NelsonBittencourt/PicArd/schematics/readme.md

# PicArd - Ultra-Low Cost PIC Programmer

## PicArd - Schematics

|  File | Description  |
| :--- | :---|
|*PicArd_Programmer_Hardware_Rev_3.pdf*| Current Hardware Programmer. Use this for new projects|
|*PicArd_Programmer_Hardware_Rev_2.pdf*| <b>For PICs with a 5V operating voltage</b>: use this revision as is (you can remove R12, R13, Q6, and Q7).<br><br><b>For PICs with an operating voltage below 5V</b>: adapt revision 2 with a level-shifter or use revision 3. |
|*PicArd_Programmer_Hardware_Rev_1_DEPRECATED.pdf* | Old Hardware Programmer. Not recommended for new projects |
