NelsonBittencourt/PicArd/Uno_Shield/readme.md

# PicArd - Ultra-Low Cost PIC Programmer

## PicArd - Arduino Uno Shield - Gerber Files

|  File | Description  |
| :--- | :---|
|*PicArd_Uno_Shield_Revision_3.zip*| Comming soon.|
|*PicArd_Uno_Shield_Revision_2.zip*| <b>For PICs with a 5V operating voltage</b>: use this revision as is (you can remove R12, R13, Q6, and Q7).<br><br><b>For PICs with an operating voltage below 5V</b>: adapt revision 2 with a level-shifter or use revision 3. |
|*PicArd_Uno_Shield_Revision_1_DEPRECATED.zip* | Old Hardware Programmer. Not recommended for new projects |
