NelsonBittencourt/PicArd/images/Picard_Hardware_041_Connection_Example_1.png

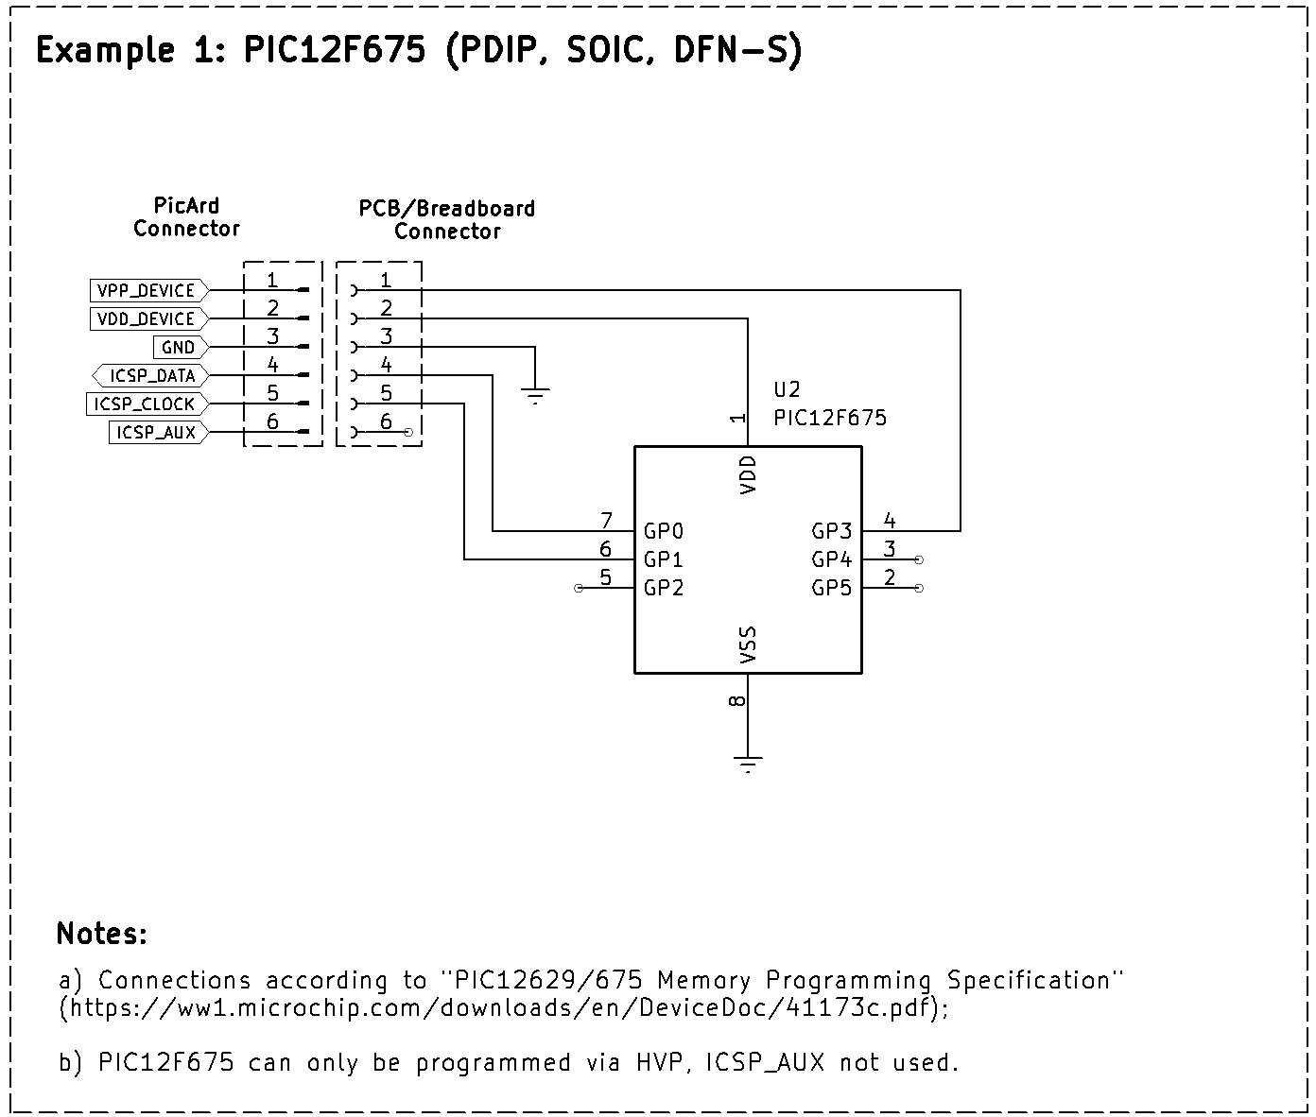
images/Picard_Hardware_041_Connection_Example_1.png
