NelsonBittencourt/PicArd/images/Picard_Hardware_041_Connection_Example_2.png

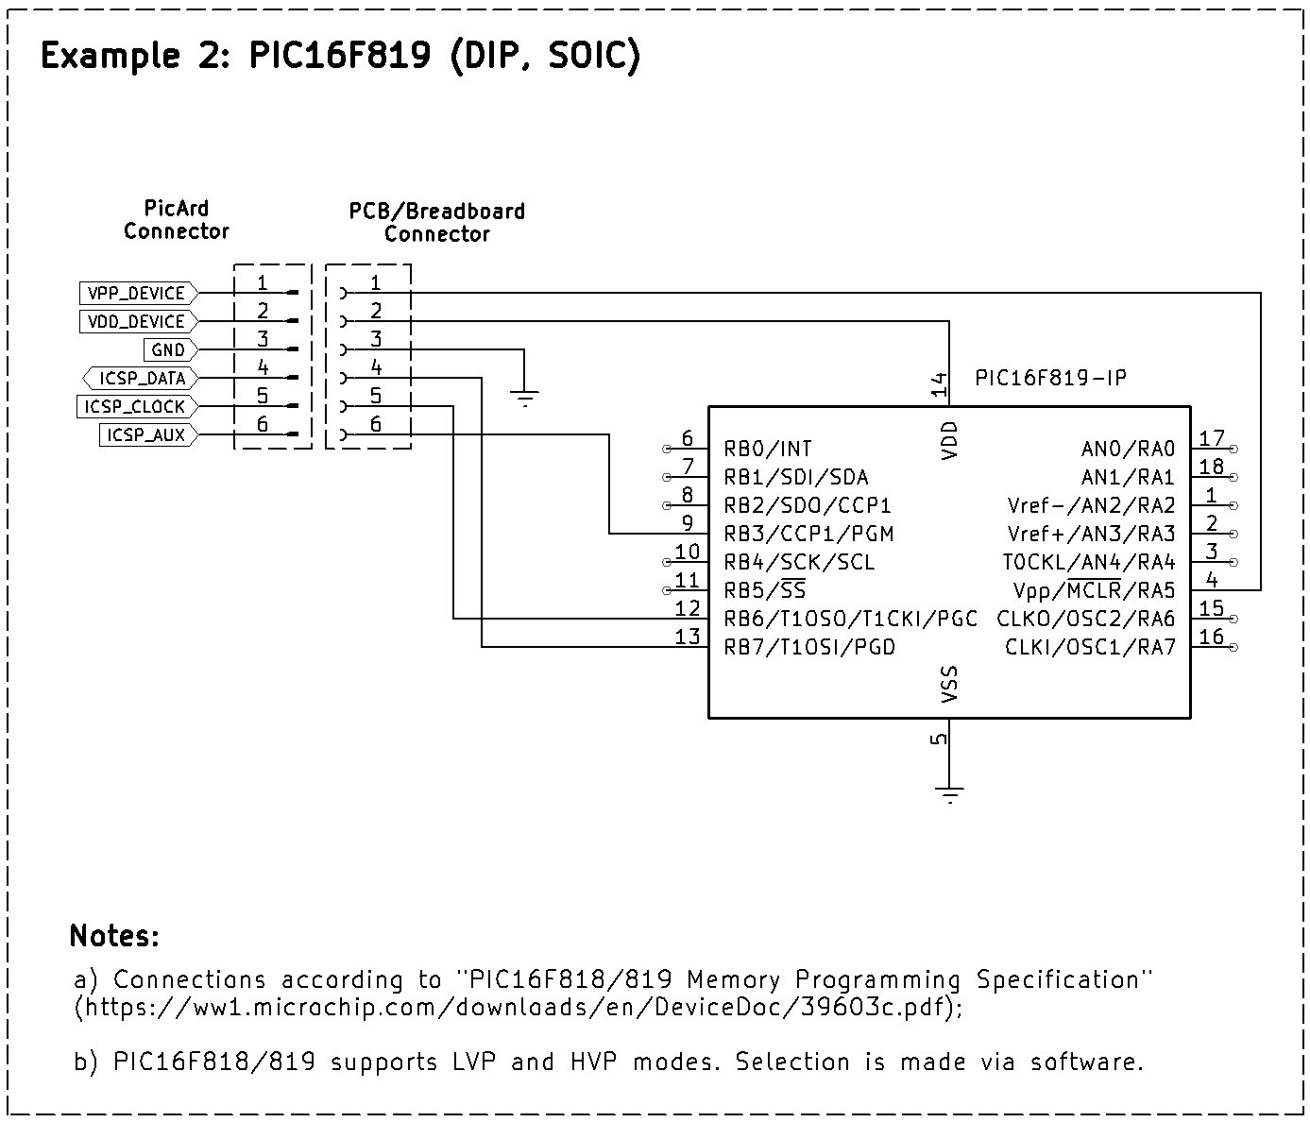
images/Picard_Hardware_041_Connection_Example_2.png
