NelsonBittencourt/PicArd/images/Picard_Hardware_041_VDD_Selection.png

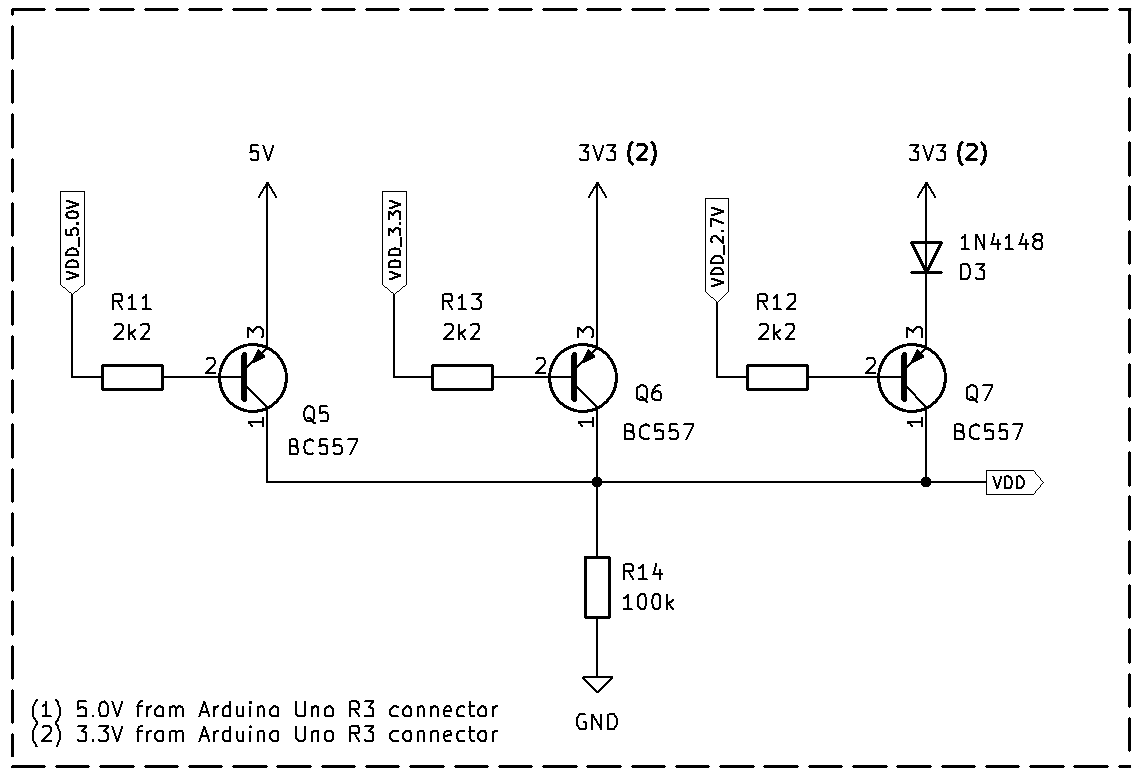
images/Picard_Hardware_041_VDD_Selection.png
