NelsonBittencourt/PicArd/images/Picard_Hardware_041_Voltages_Control.png

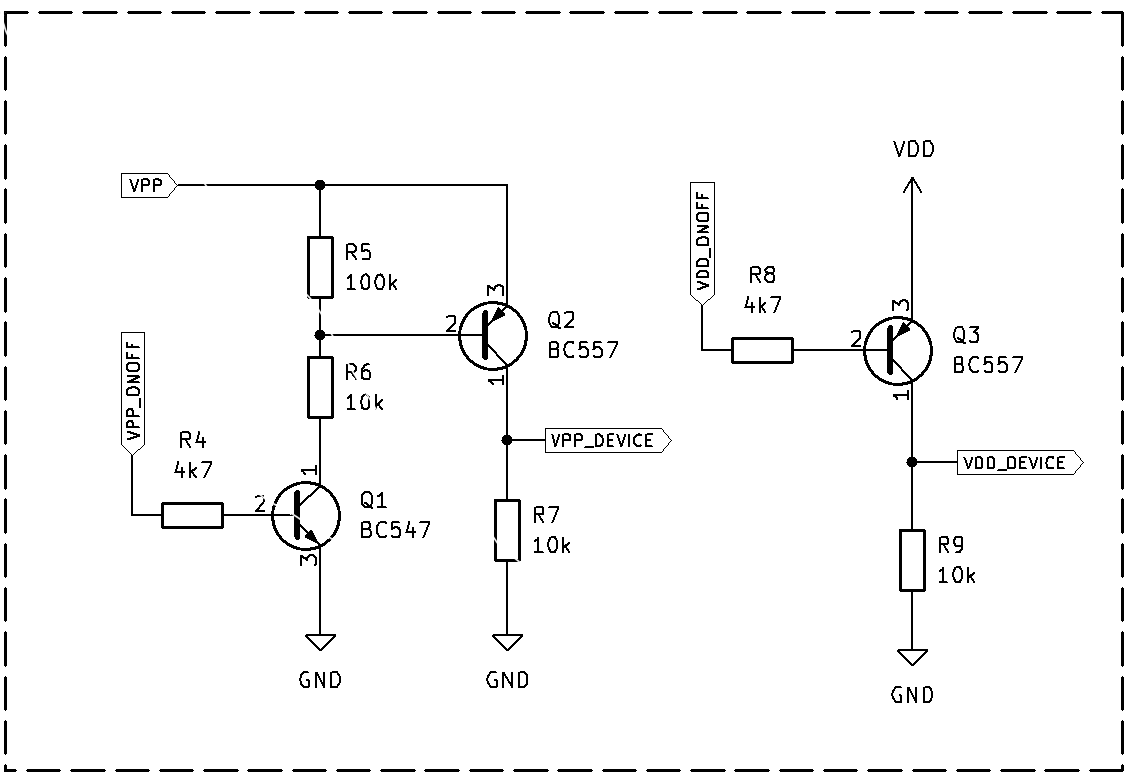
images/Picard_Hardware_041_Voltages_Control.png
