NelsonBittencourt/PicArd/images/Picard_Hardware_042_DC_DC_booster.png

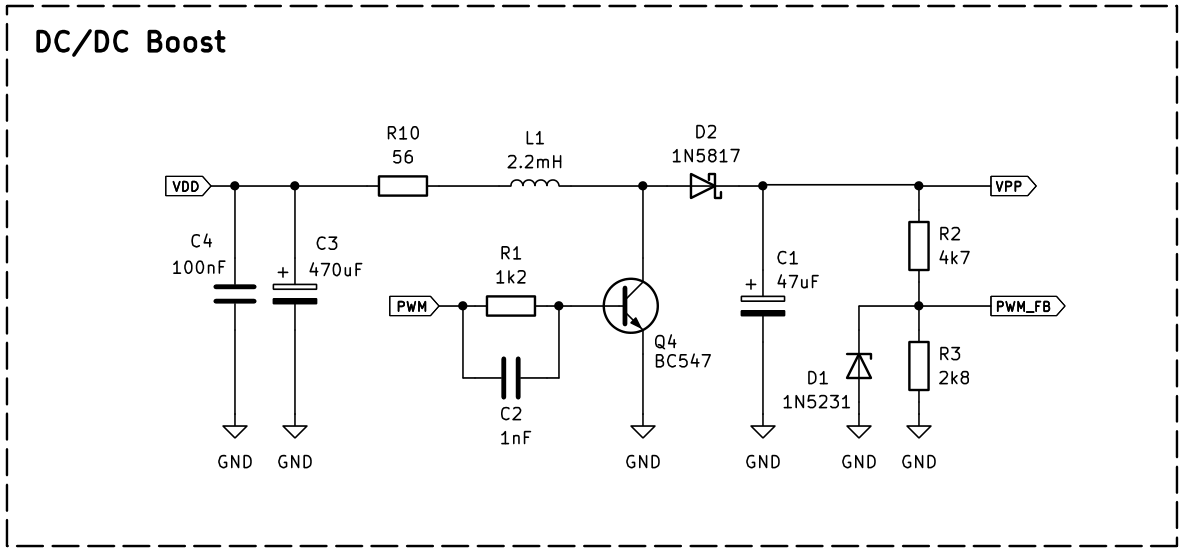
images/Picard_Hardware_042_DC_DC_booster.png
