NelsonBittencourt/PicArd/images/PicArd_Hardware_Uno_Shield_Rev_2_Ray.png

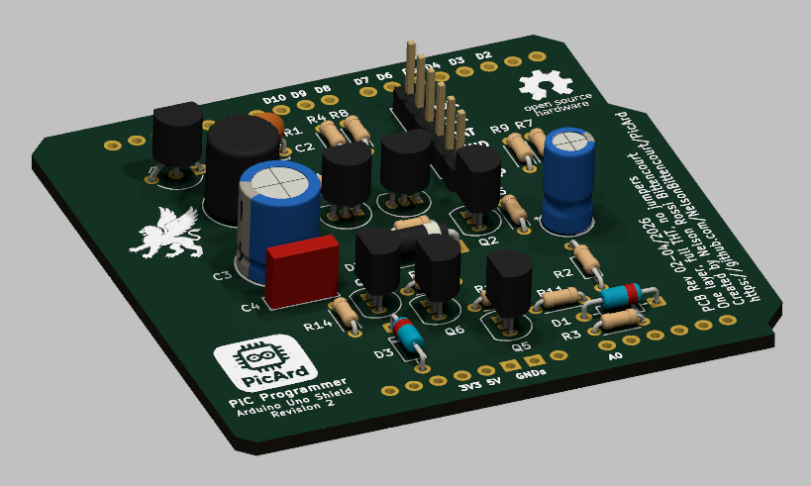
images/PicArd_Hardware_Uno_Shield_Rev_2_Ray.png
