NelsonBittencourt/PicArd/schematics/PicArd_Programmer_Hardware_Rev_3.pdf

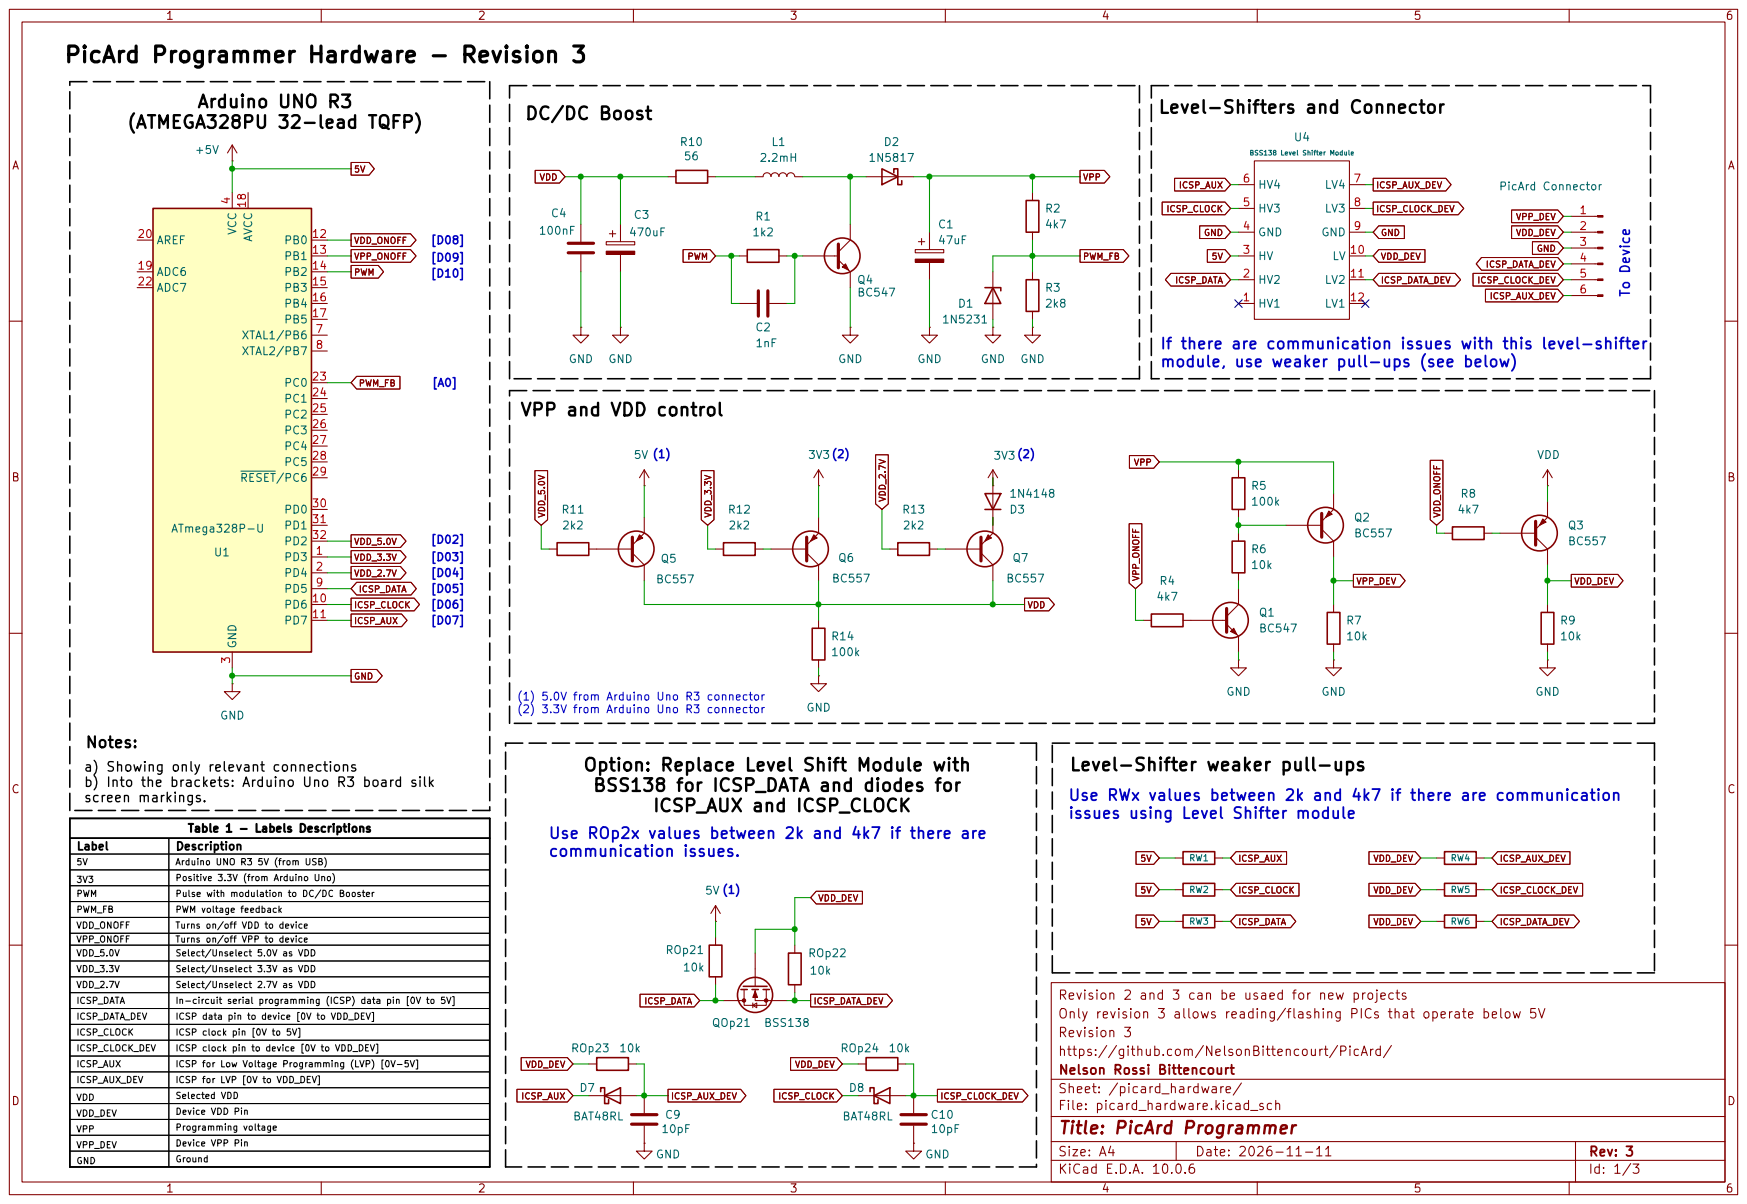
[picture p16: page 1]

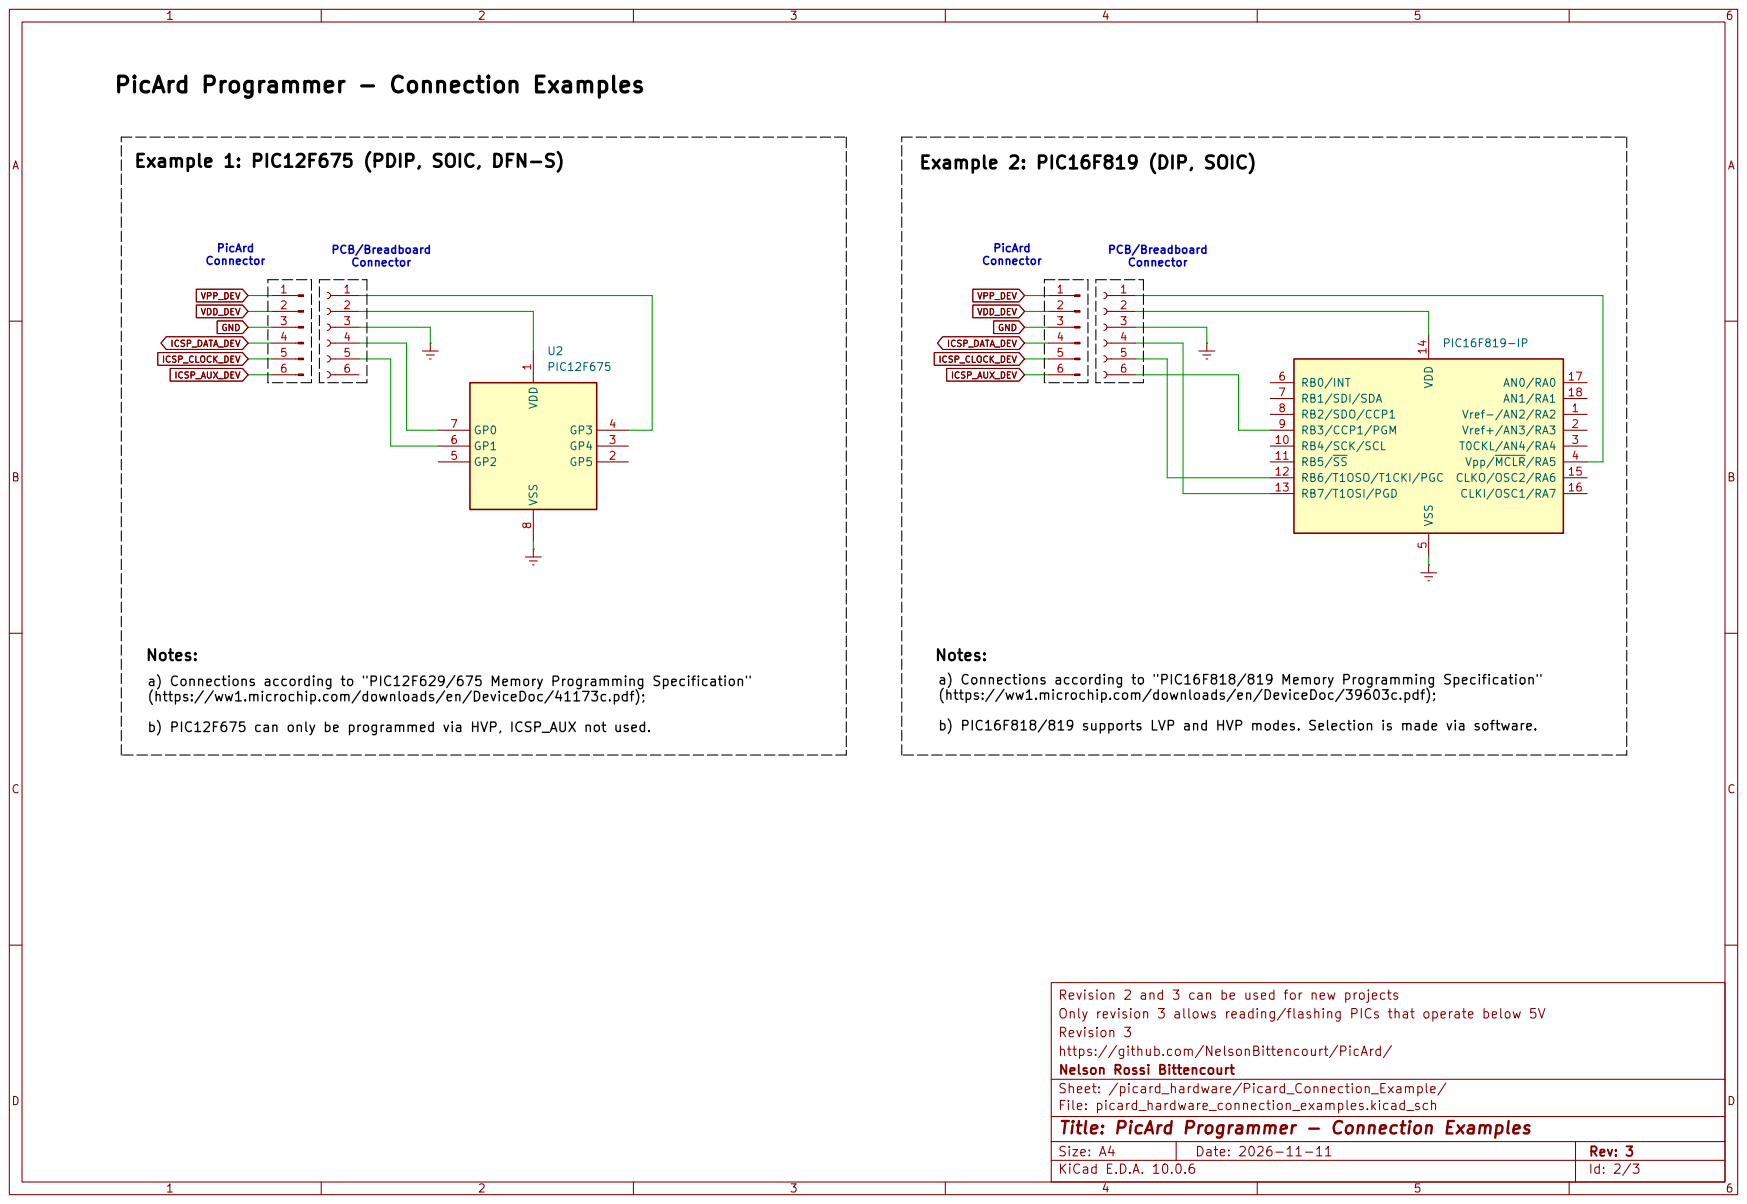
[picture p17: page 2]

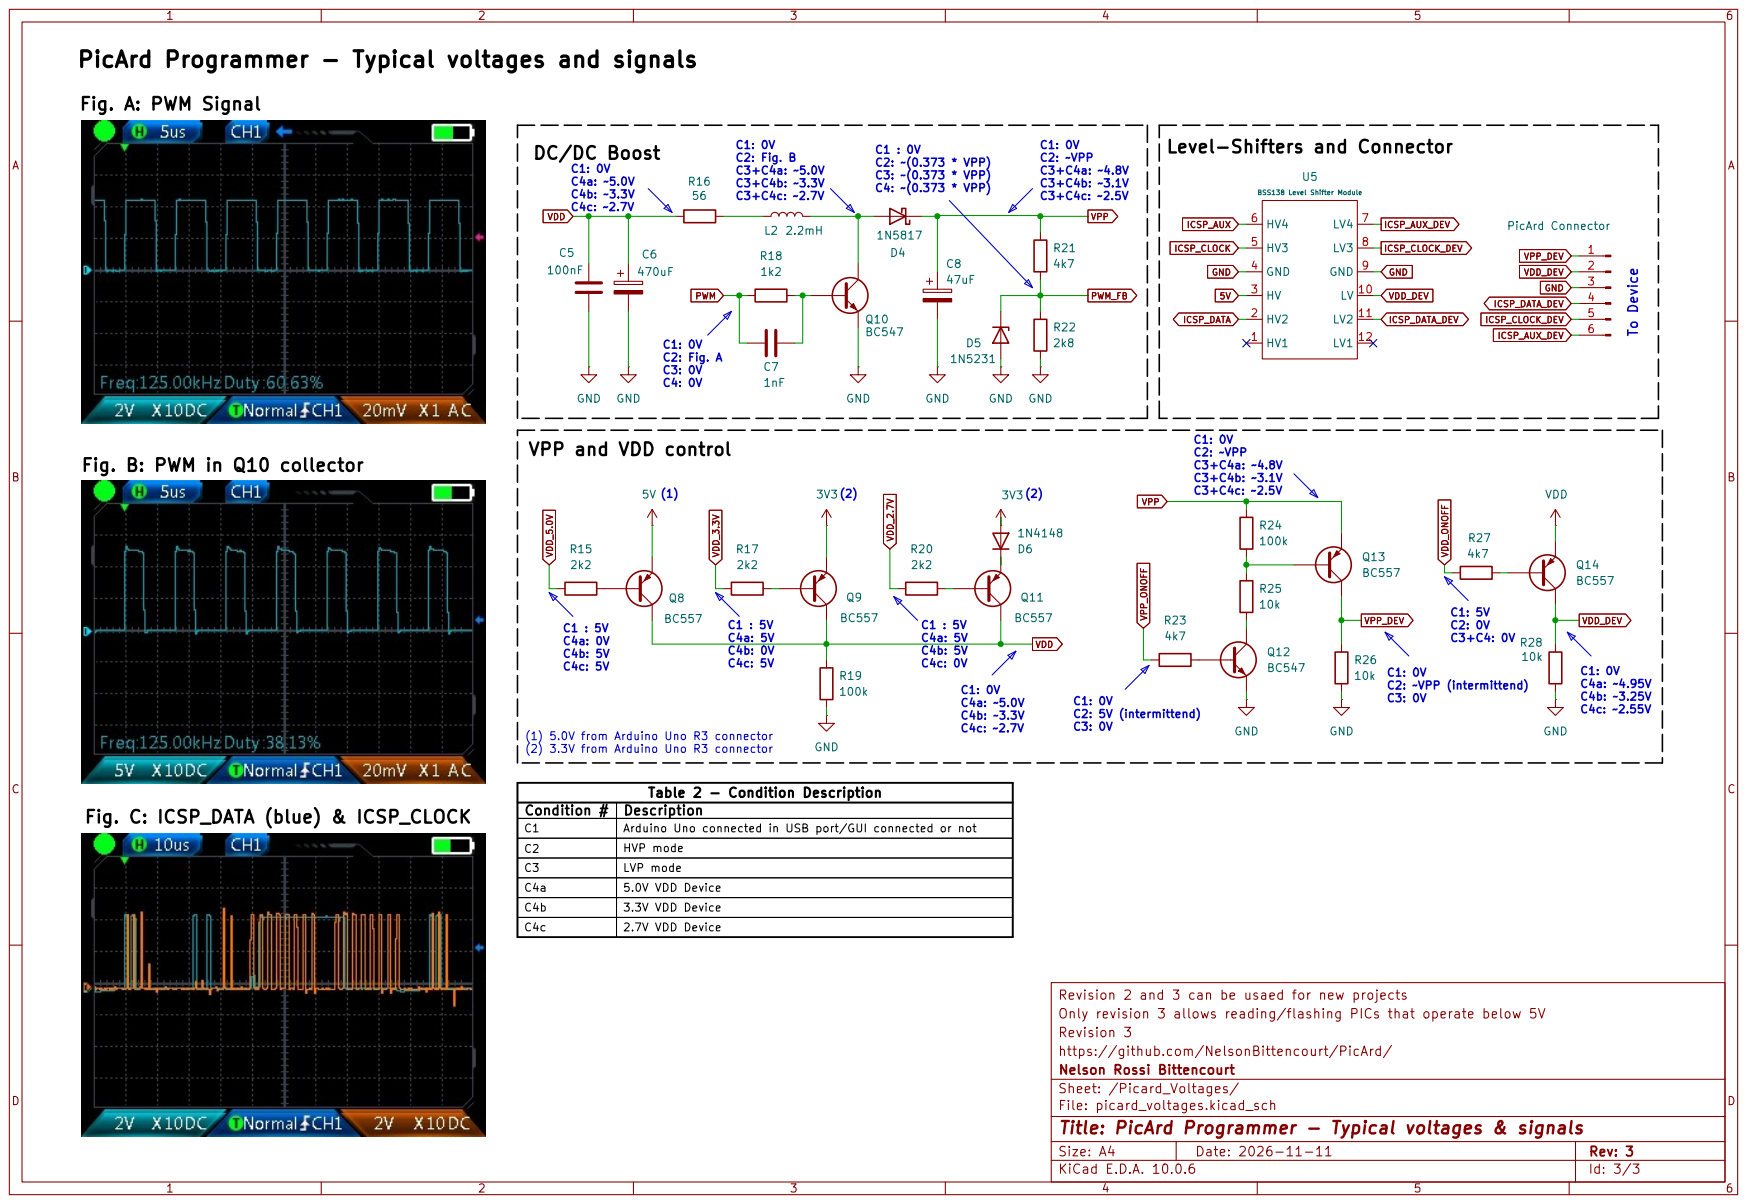
[picture p18: page 3]
