NelsonBittencourt/PicArd/schematics/PicArd_Programmer_Hardware_Rev_2.pdf

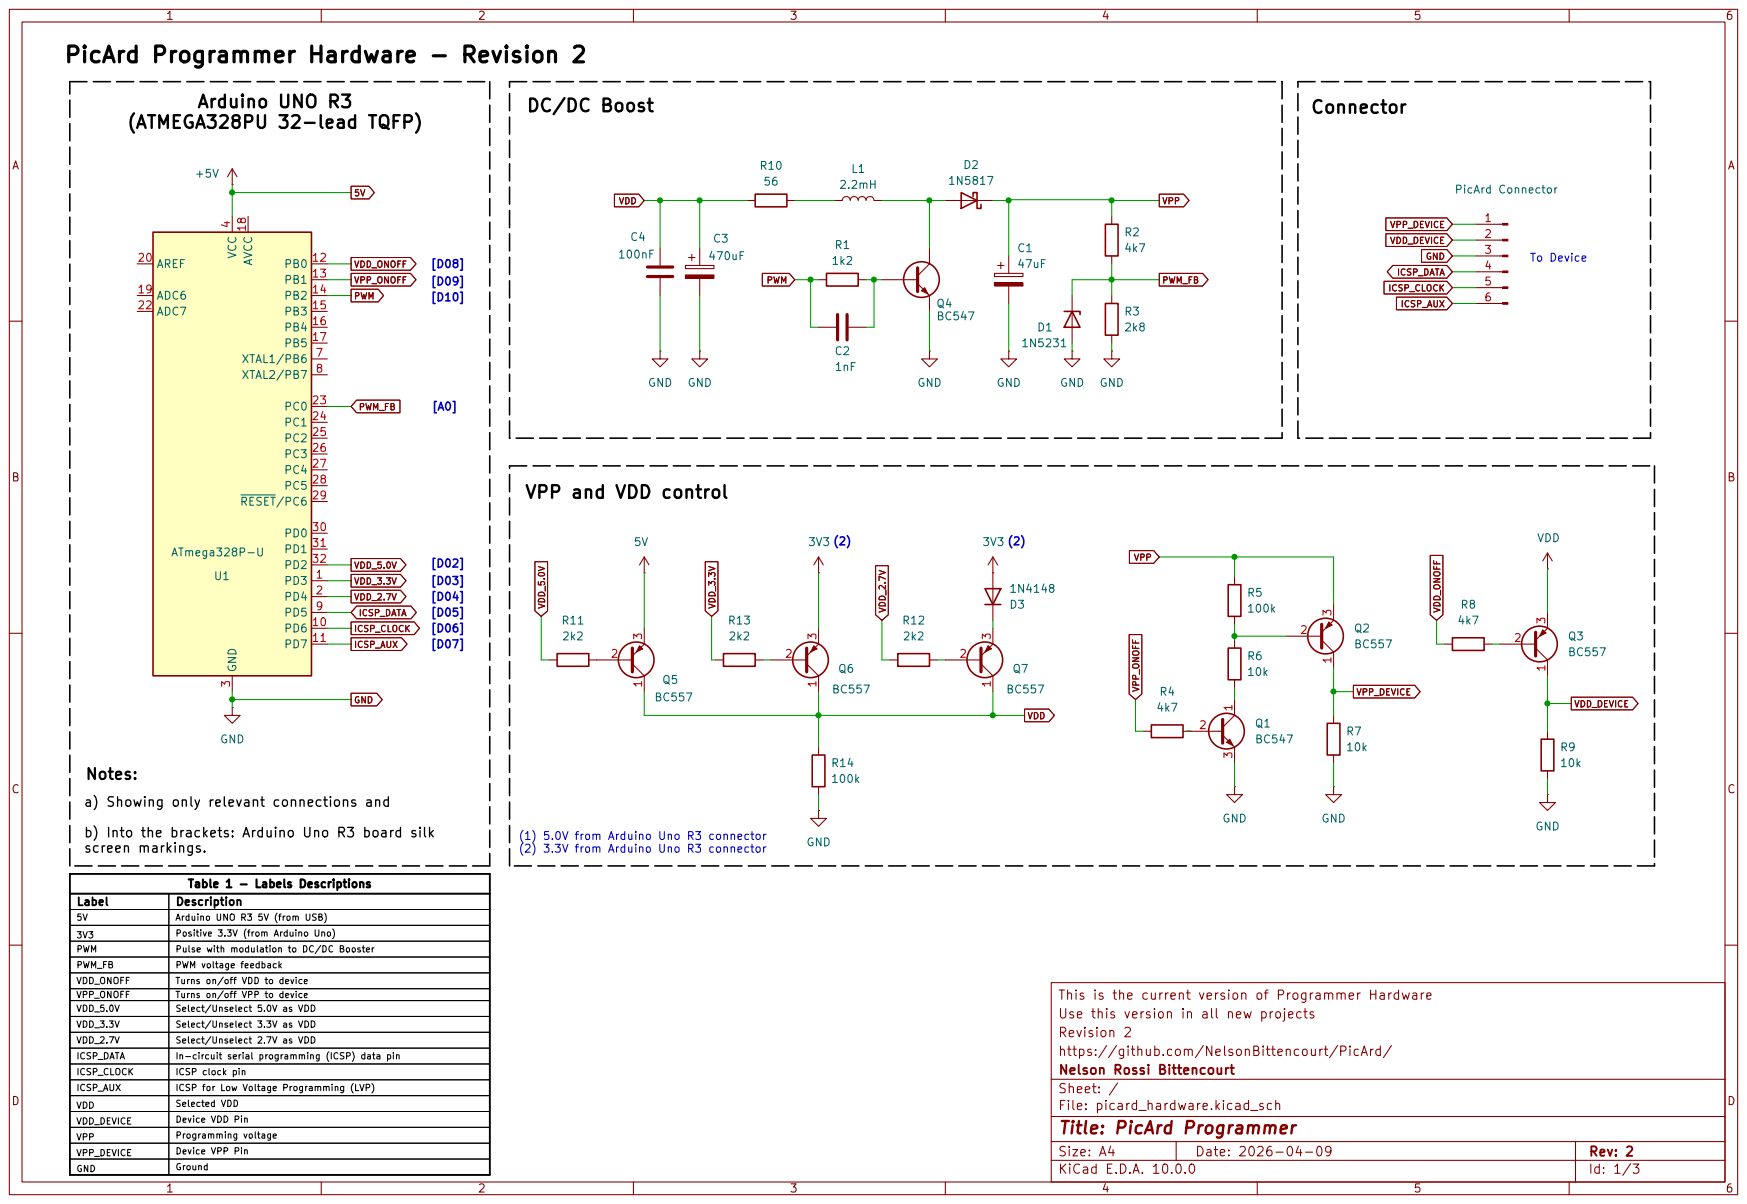
[picture p22: page 1]

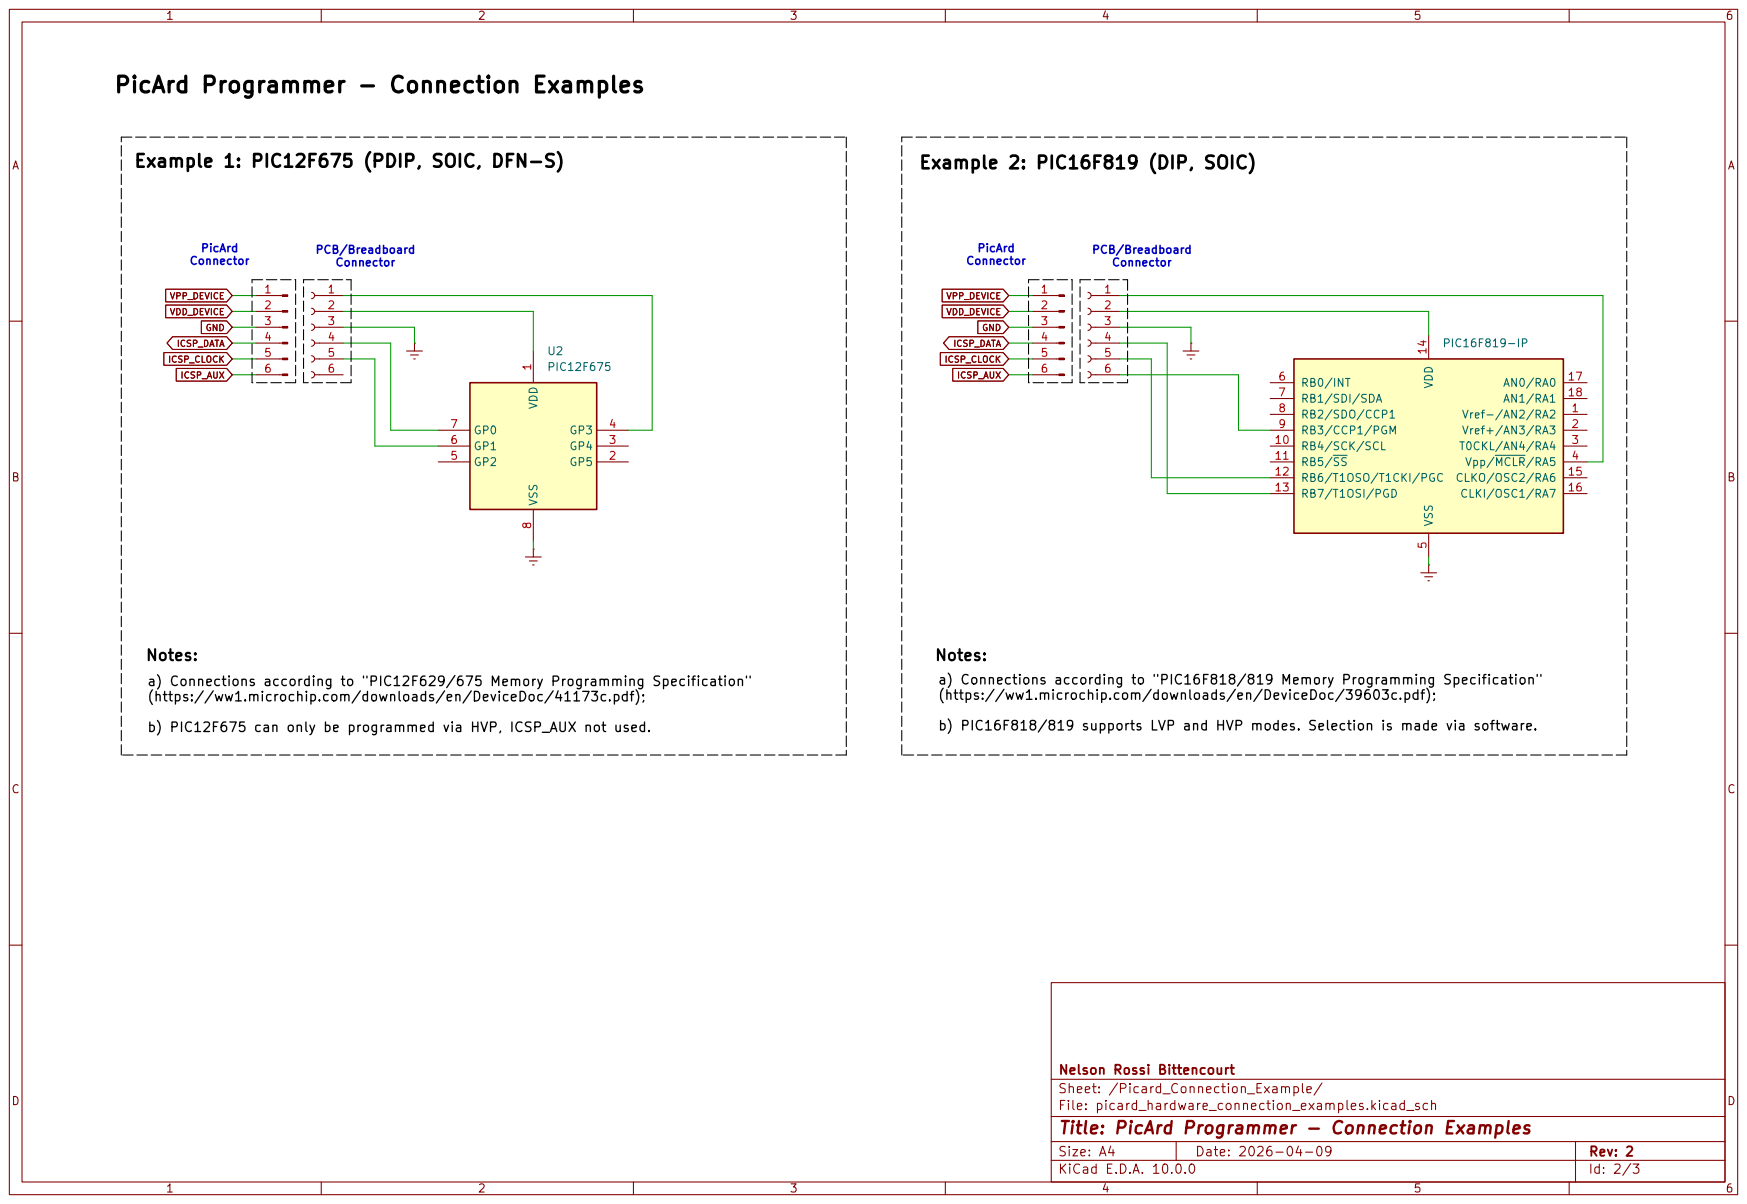
[picture p23: page 2]

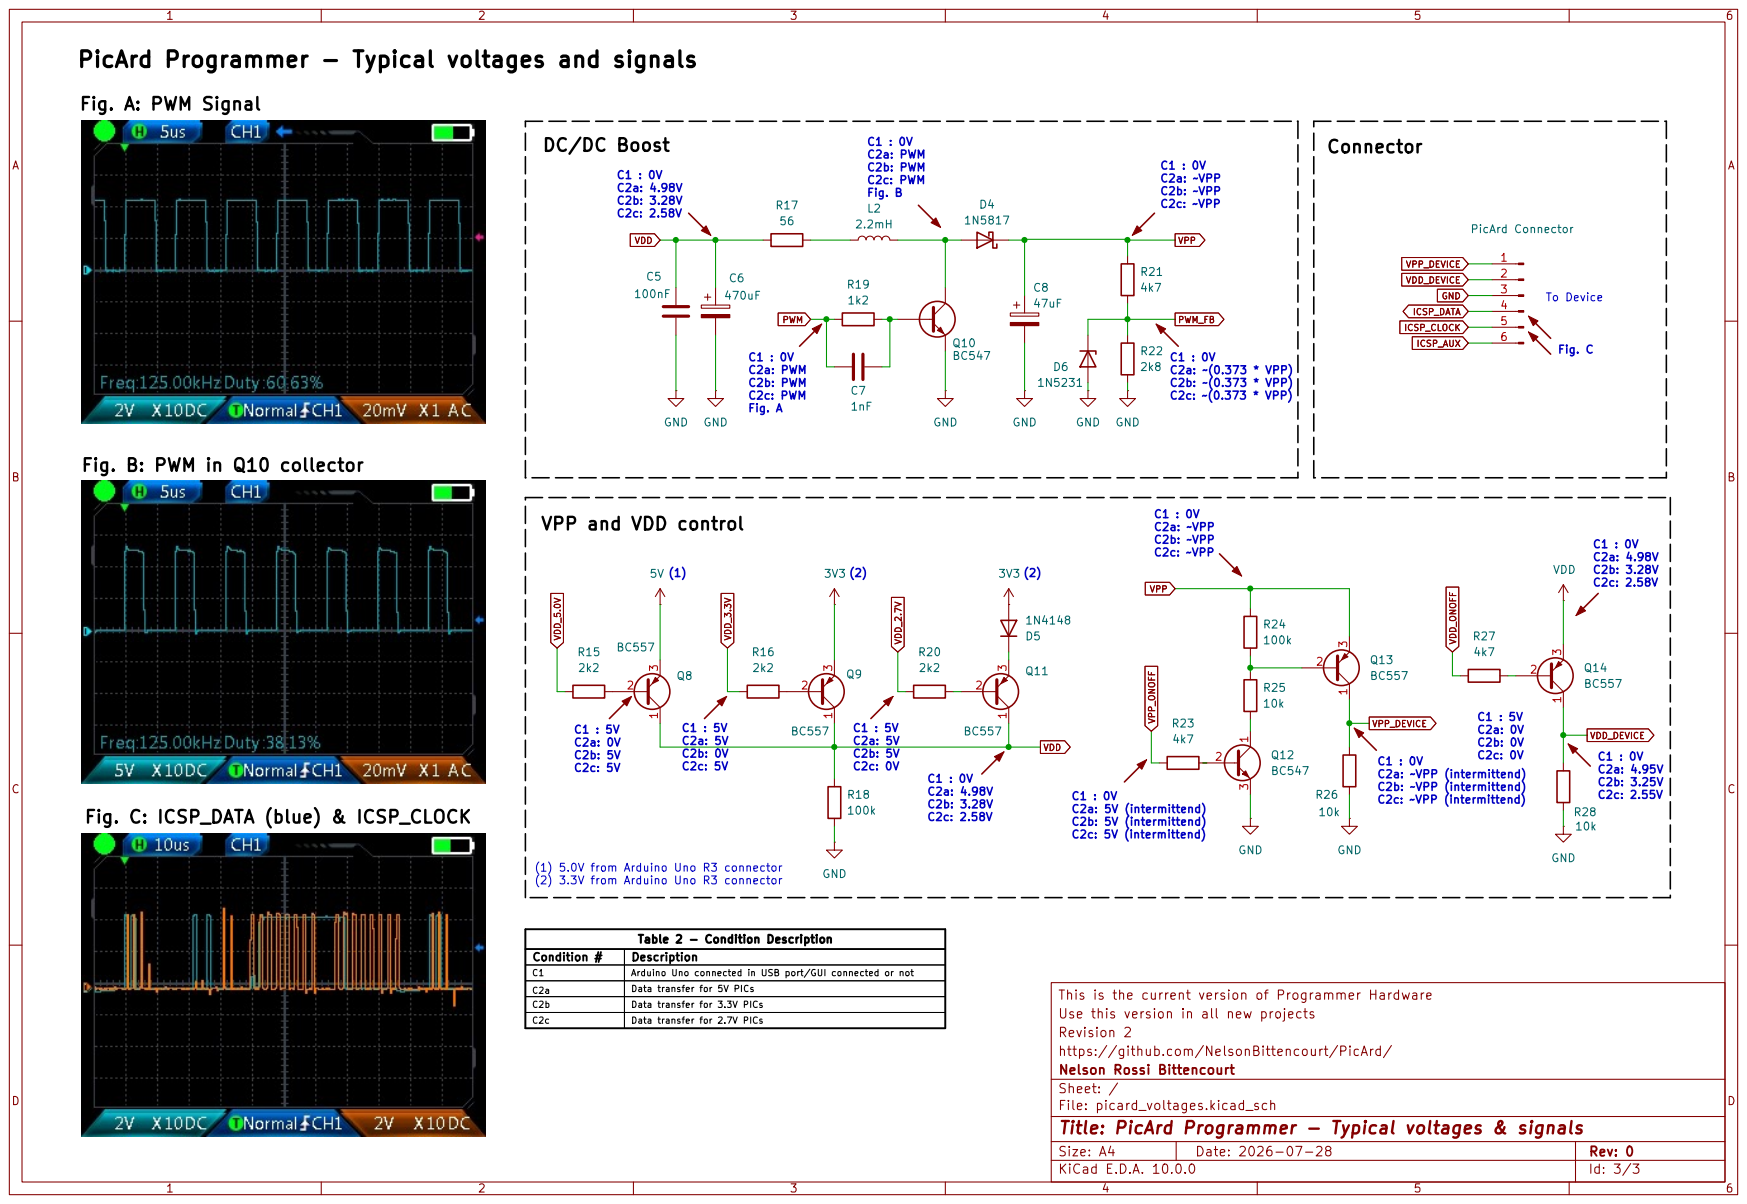
[picture p24: page 3]
