NelsonBittencourt/PicArd/(commit log)

2026-02-23 Arduino Uno Shield - Gerber Files
2026-02-23 Added Arduino Uno Shield Gerber Files
2026-04-09 v042
    Changes:
    -PWM output pin from D11 to D10 and
    -Footprints (R2, R10 e T4).
2026-04-09 v042
    -PWM frequency (from 62.5kHz to 125kHz);
    -New PID parameters;
    -Anti-windup;
    -Feed-back voltage new scan time and
    -Minor changes for increase code performance.
    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
2026-07-27 07/27/2026 - Bug fix for Arduino Uno Clones
2026-07-27 Bug fix for PWM stability
2026-09-04 0.42 Current Version
2026-09-04 Tested devices list updated
2026-09-04 0.41 Schematic Deprecated Version
2026-09-09 Update gerber files and readme
    1 ) Replace version numbers with revision numbers;
    2) New gerber files only for clarification on the deprecation of Revision 01 board and
    3) New readme text for clarification on the deprecation of Revision 1 (old version 0.41).
2026-09-09 New files for Programmer Hardware
    a) Clarification on the deprecation of Revision 1 (old version 0.41) and
    b) Added page with typical voltages and signals.
2026-09-09 Added schematics folder
    Schematics was removed from 'docs' folder.
2026-09-30 5V IC Pins Alert
2026-10-06 Added tested devices list
2026-10-06 Added: Tested Devices List
2026-10-07 Tested Devices List Updated with PIC12F508
2026-10-14 Update Tested Devices with PIC16C84
2026-10-19 Tested Devices Updated with PIC18F14K50
2026-10-24 5V Issue (cc: @username)
2026-10-24 5V rail issue (cc: @lalo-yu)
